baconspoon85/Birdie/README.md

# Birdie
Birdie is 36-key wireless keyboard inspired by Adalyn (Alice/QAZ style)

This as a work in progress. Still need firmware and a case. Feel free to contrtribute if you're interested in moving this along.
