baconspoon85/Birdie/Birdie/Switch Footprint Layout.dxf

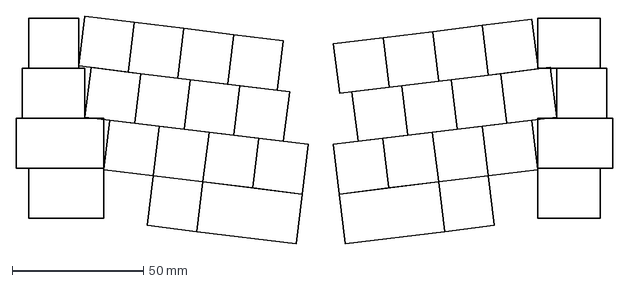
[picture p1: CAD file, 2023-11-30]
Birdie/Switch Footprint Layout.dxf
227.3 x 86.7 mm
