baconspoon85/Birdie/Birdie/Birdie.kicad_pcb

## KiCad design Birdie/Birdie.kicad_pcb (2023-11-30)

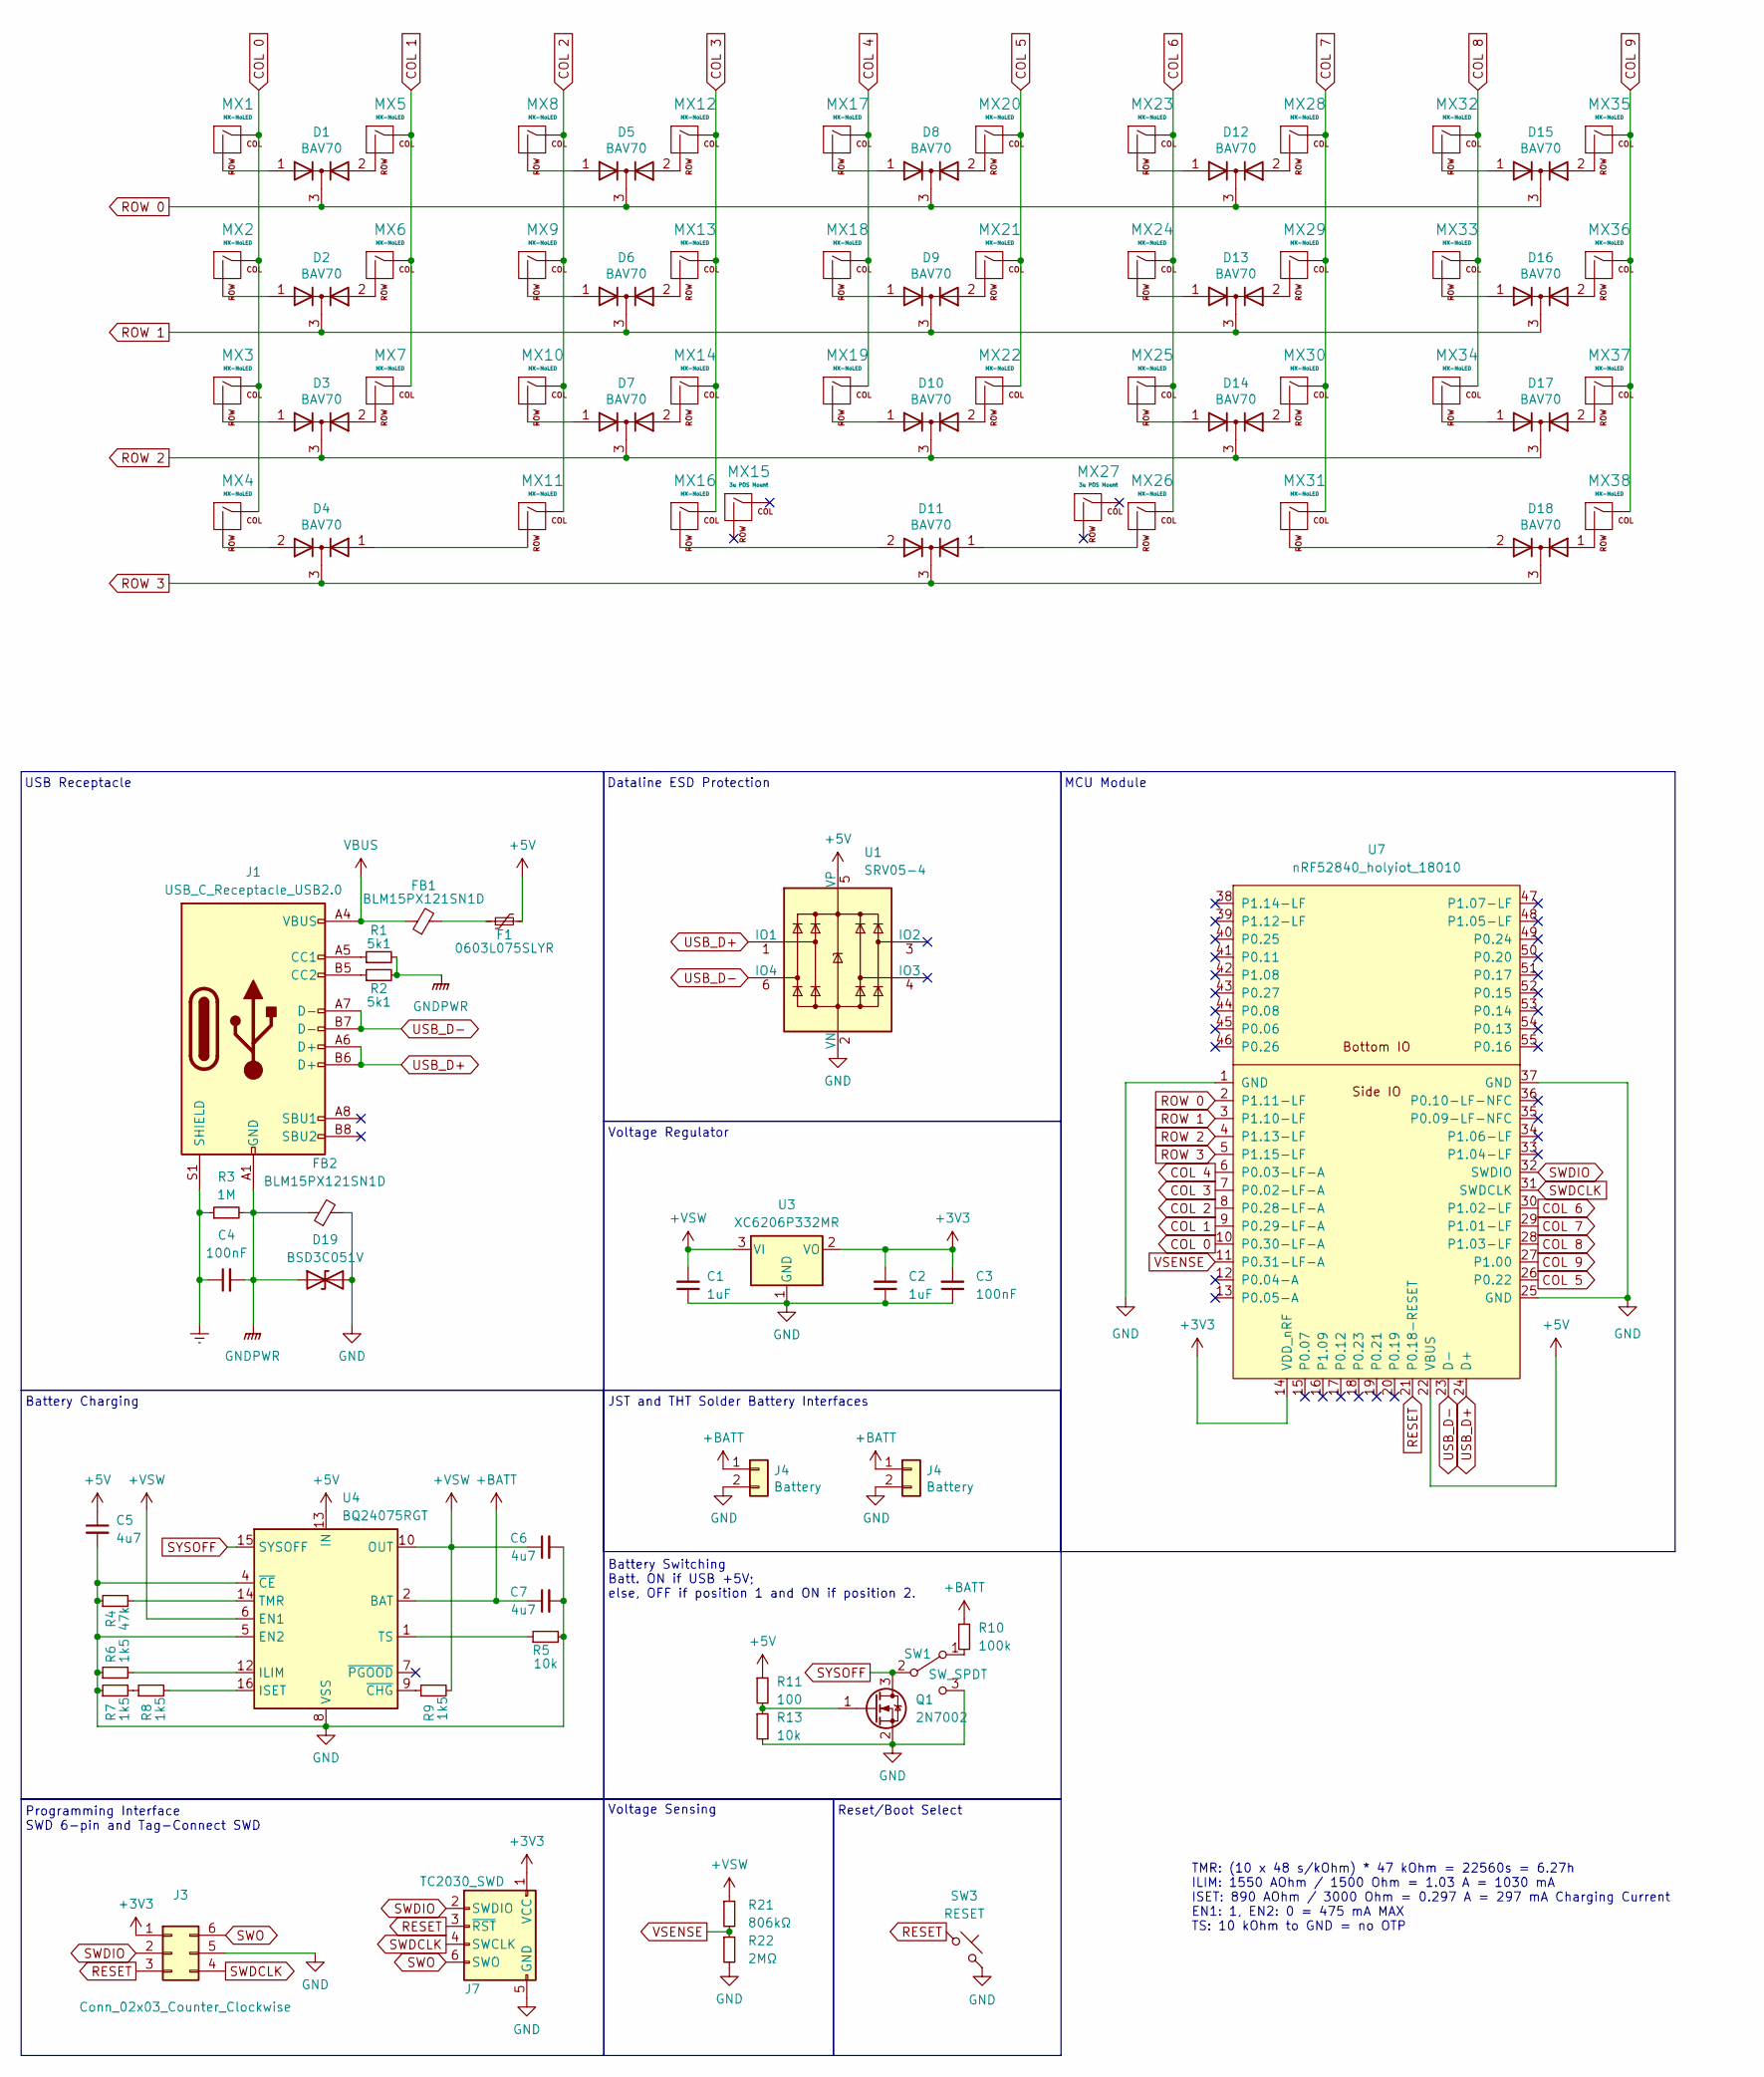
[picture p2: schematic Birdie.kicad_sch]

Parts:
C1, C2: 1uF; C_0402_1005Metric; LCSC C52923
C3, C4: 100nF; C_0402_1005Metric; LCSC C2655418
C5, C6, C7: 4u7; C_0402_1005Metric; LCSC C541466
D1: BAV70; SOT-23; LCSC C154830
D2, D3, D4, D5, D6, D7, D8, D9, D10, D11, D12, D13, D14, D15, D16, D17, D18: BAV70; SOT-23
D19: BSD3C051V; D_SOD-323; LCSC C1519956
F1: 0603L075SLYR; Fuse_0603_1608Metric; LCSC C207016
FB1, FB2: BLM15PX121SN1D; L_0402_1005Metric; LCSC C88970
J1: USB_C_Receptacle_USB2.0; USB_C_Receptacle_HRO_TYPE-C-31-M-12; LCSC C165948
J3: Conn_02x03_Counter_Clockwise; PinHeader_2x03_P2.54mm_Vertical
J4: Battery; JST_PH_S2B-PH-K_1x02_P2.00mm_Horizontal
J7: TC2030_SWD; CON_TC2030_outlined
MX1, MX5, MX6, MX7, MX8, MX9, MX10, MX11, MX12, MX13, MX14, MX17, MX18, MX19, MX20, MX21, MX22, MX23, MX24, MX25, MX28, MX29, MX30, MX31, MX32, MX33, MX34, MX36: MX-NoLED; MXOnly-1U-Hotswap
MX2, MX35, MX38: MX-NoLED; MXOnly-1.25U-Hotswap
MX3: MX-NoLED; MXOnly-1.75U-Hotswap
MX4, MX37: MX-NoLED; MXOnly-1.5U-Hotswap
MX15, MX27: 3u POS Mount; MXOnly-1U-Hotswap
MX16, MX26: MX-NoLED; MXOnly-2U-Hotswap-ReversedStabilizers
Q1: 2N7002; SOT-23; LCSC C8545
R1, R2: 5k1; R_0402_1005Metric; LCSC C103086
R3: 1M; R_0603_1608Metric; LCSC C3016422
R4: 47k; R_0402_1005Metric; LCSC C5455484
R5, R13: 10k; R_0402_1005Metric; LCSC C705657
R6, R7, R8, R9: 1k5; R_0402_1005Metric; LCSC C3015796
R10: 100k; R_0402_1005Metric; LCSC C319963
R11: 100; R_0402_1005Metric; LCSC C319948
R21: 806kΩ; R_0402_1005Metric; LCSC C3016043
R22: 2MΩ; R_0402_1005Metric; LCSC C3015935
SW1: SW_SPDT; SW_SPDT_PCM12; LCSC C221841
SW3: RESET; SW_SPST_TL3342; LCSC C318884
U1: SRV05-4; SOT-23-6-routable; LCSC C2972082
U3: XC6206P332MR; SOT-23-3; LCSC C5250985
U4: BQ24075RGT; VQFN-16-1EP_3x3mm_P0.5mm_EP1.6x1.6mm; LCSC C2865459
U7: nRF52840_holyiot_18010

Connections:
+3V3: C2.2, C3.2, J3.1, U3.2 (VO); also elsewhere on the board
+5V: C5.1, F1.2, R11.1, U1.5 (VP), U4.13 (IN); also elsewhere on the board
+BATT: C7.1, J4.1, R10.1, U4.2 (BAT), U4.3 (BAT); also elsewhere on the board
+VSW: C1.2, C6.1, R9.2, U3.3 (VI), U4.6 (EN1), U4.10 (OUT), U4.11 (OUT); also elsewhere on the board
COL 0: MX1.1 (COL), MX2.1 (COL), MX3.1 (COL), MX4.1 (COL); also elsewhere on the board
COL 1: MX5.1 (COL), MX6.1 (COL), MX7.1 (COL); also elsewhere on the board
COL 2: MX8.1 (COL), MX9.1 (COL), MX10.1 (COL), MX11.1 (COL); also elsewhere on the board
COL 3: MX12.1 (COL), MX13.1 (COL), MX14.1 (COL), MX16.1 (COL); also elsewhere on the board
COL 4: MX17.1 (COL), MX18.1 (COL), MX19.1 (COL); also elsewhere on the board
COL 5: MX20.1 (COL), MX21.1 (COL), MX22.1 (COL); also elsewhere on the board
COL 6: MX23.1 (COL), MX24.1 (COL), MX25.1 (COL), MX26.1 (COL); also elsewhere on the board
COL 7: MX28.1 (COL), MX29.1 (COL), MX30.1 (COL), MX31.1 (COL); also elsewhere on the board
COL 8: MX32.1 (COL), MX33.1 (COL), MX34.1 (COL); also elsewhere on the board
COL 9: MX35.1 (COL), MX36.1 (COL), MX37.1 (COL), MX38.1 (COL); also elsewhere on the board
Earth: C4.1, J1.S1 (SHIELD), R3.1
GND: C1.1, C2.1, C3.1, C5.2, C6.2, C7.2, D19.2 (A2), FB2.2, J3.5, J4.2, Q1.2 (S), R4.1, R5.2, R6.1, R7.1, R13.2, SW1.3 (C), U1.2 (VN), U3.1 (GND), U4.4 (~CE), U4.5 (EN2), U4.8 (VSS), U4.17 (VSS); also elsewhere on the board
GNDPWR: C4.2, D19.1 (A1), FB2.1, J1.A1 (GND), J1.A12 (GND), J1.B1 (GND), J1.B12 (GND), R1.2, R2.2, R3.2
unnamed: F1.1, FB1.2
unnamed: J1.A5 (CC1), R1.1
unnamed: J1.B5 (CC2), R2.1
unnamed: D1.1 (A), MX1.2 (ROW)
unnamed: D2.1 (A), MX2.2 (ROW)
unnamed: D3.1 (A), MX3.2 (ROW)
unnamed: D4.2 (A), MX4.2 (ROW)
unnamed: D1.2 (A), MX5.2 (ROW)
unnamed: D2.2 (A), MX6.2 (ROW)
unnamed: D3.2 (A), MX7.2 (ROW)
unnamed: D5.1 (A), MX8.2 (ROW)
unnamed: D6.1 (A), MX9.2 (ROW)
unnamed: D7.1 (A), MX10.2 (ROW)
unnamed: D4.1 (A), MX11.2 (ROW)
unnamed: D5.2 (A), MX12.2 (ROW)
unnamed: D6.2 (A), MX13.2 (ROW)
unnamed: D7.2 (A), MX14.2 (ROW)
unnamed: D11.2 (A), MX16.2 (ROW)
unnamed: D8.1 (A), MX17.2 (ROW)
unnamed: D9.1 (A), MX18.2 (ROW)
unnamed: D10.1 (A), MX19.2 (ROW)
unnamed: D8.2 (A), MX20.2 (ROW)
unnamed: D9.2 (A), MX21.2 (ROW)
unnamed: D10.2 (A), MX22.2 (ROW)
unnamed: D12.1 (A), MX23.2 (ROW)
unnamed: D13.1 (A), MX24.2 (ROW)
unnamed: D14.1 (A), MX25.2 (ROW)
unnamed: D11.1 (A), MX26.2 (ROW)
unnamed: D12.2 (A), MX28.2 (ROW)
unnamed: D13.2 (A), MX29.2 (ROW)
unnamed: D14.2 (A), MX30.2 (ROW)
unnamed: D18.2 (A), MX31.2 (ROW)
unnamed: D15.1 (A), MX32.2 (ROW)
unnamed: D16.1 (A), MX33.2 (ROW)
unnamed: D17.1 (A), MX34.2 (ROW)
unnamed: D15.2 (A), MX35.2 (ROW)
unnamed: D16.2 (A), MX36.2 (ROW)
unnamed: D17.2 (A), MX37.2 (ROW)
unnamed: D18.1 (A), MX38.2 (ROW)
unnamed: Q1.1 (G), R11.2, R13.1
unnamed: R7.2, R8.1
unnamed: R10.2, SW1.1 (A)
unnamed: R6.2, U4.12 (ILIM)
unnamed: R8.2, U4.16 (ISET)
unnamed: R4.2, U4.14 (TMR)
unnamed: R5.1, U4.1 (TS)
unnamed: R9.1, U4.9 (~CHG)
RESET: J3.3; also elsewhere on the board
ROW 0: D1.3 (K), D5.3 (K), D8.3 (K), D12.3 (K), D15.3 (K); also elsewhere on the board
ROW 1: D2.3 (K), D6.3 (K), D9.3 (K), D13.3 (K), D16.3 (K); also elsewhere on the board
ROW 2: D3.3 (K), D7.3 (K), D10.3 (K), D14.3 (K), D17.3 (K); also elsewhere on the board
ROW 3: D4.3 (K), D11.3 (K), D18.3 (K); also elsewhere on the board
SWDCLK: J3.4; also elsewhere on the board
SWDIO: J3.2; also elsewhere on the board
SWO: J3.6; also elsewhere on the board
SYSOFF: Q1.3 (D), SW1.2 (B), U4.15 (SYSOFF)
USB_D+: J1.A6 (D+), J1.B6 (D+), U1.1 (IO1); also elsewhere on the board
USB_D-: J1.A7 (D-), J1.B7 (D-), U1.6 (IO4); also elsewhere on the board
VBUS: FB1.1, J1.A4 (VBUS), J1.A9 (VBUS), J1.B4 (VBUS), J1.B9 (VBUS)

Notes on the sheet:
MCU Module
Reset/Boot Select
Programming Interface SWD 6-pin and Tag-Connect SWD
JST and THT Solder Battery Interfaces
Dataline ESD Protection
TMR: (10 x 48 s/kOhm) * 47 kOhm = 22560s = 6.27h ILIM: 1550 AOhm / 1500 Ohm = 1.03 A = 1030 mA ISET: 890 AOhm / 3000 Ohm = 0.297 A = 297 mA Charging Current EN1: 1, EN2: 0 = 475 mA MAX TS: 10 kOhm to GND = no OTP
USB Receptacle
Voltage Sensing
Battery Charging
Battery Switching Batt. ON if USB +5V; else, OFF if position 1 and ON if position 2.
Voltage Regulator

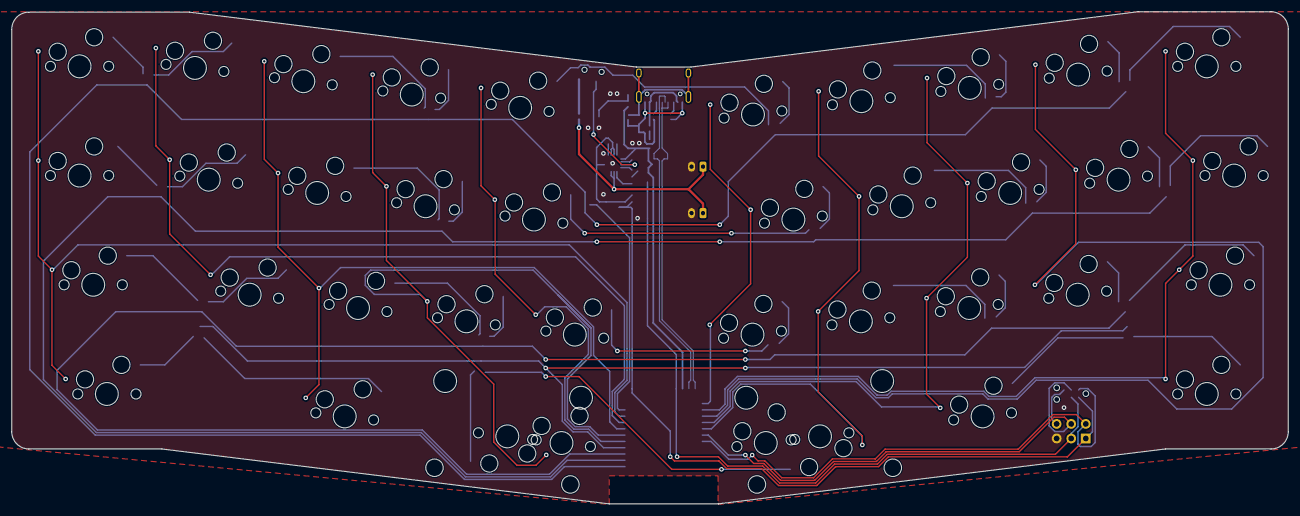
[picture p3: board Birdie.kicad_pcb from above]

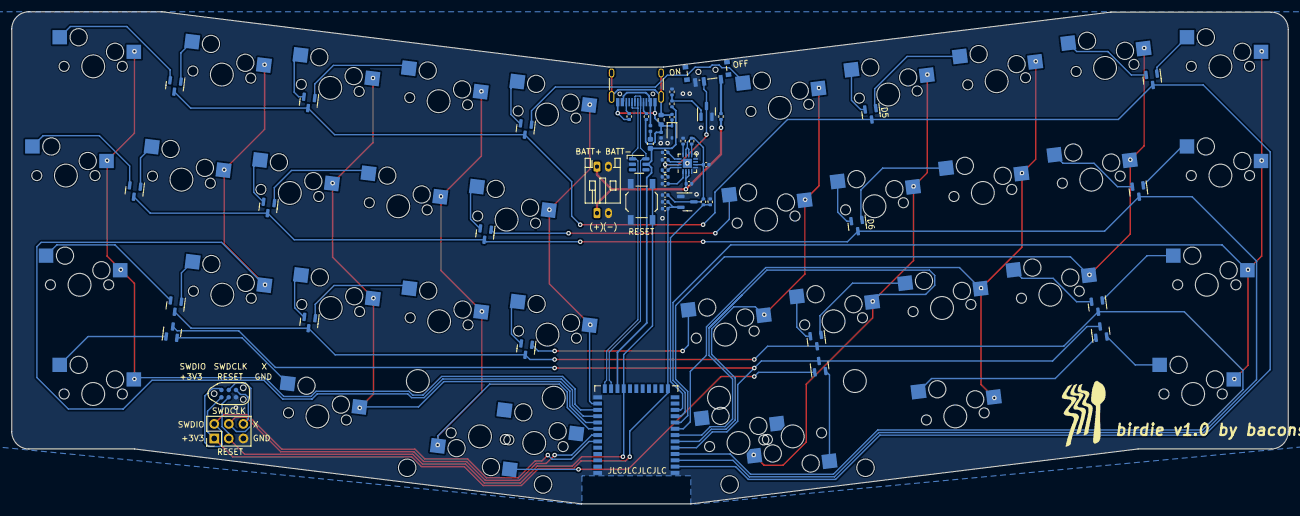
[picture p4: board Birdie.kicad_pcb from below]

Board: 2 copper layers, 222.7 x 85.8 mm, 94 parts (56 on the bottom side), 77 nets.

Other parts of the board:
G1: LOGO; baconspoon-logo-13x14mm
J2: TC2030_SWD; CON_TC2030_outlined
J5: Battery; JST_PH_S2B-PH-K_1x02_P2.00mm_Horizontal
R12: 806kΩ; R_0402_1005Metric
R14: 2MΩ; R_0402_1005Metric
SW2: RESET; SW_SPST_TL3342
U2: nRF52840_holyiot_18010

Their connections:
+3V3: J2.1 (VCC), U2.14 (VDD_nRF); also elsewhere on the board
+5V: U2.22 (VBUS); also elsewhere on the board
+BATT: J5.1; also elsewhere on the board
+VSW: R12.1; also elsewhere on the board
COL 0: U2.10 (P0.30-LF-A); also elsewhere on the board
COL 1: U2.9 (P0.29-LF-A); also elsewhere on the board
COL 2: U2.8 (P0.28-LF-A); also elsewhere on the board
COL 3: U2.7 (P0.02-LF-A); also elsewhere on the board
COL 4: U2.6 (P0.03-LF-A); also elsewhere on the board
COL 5: U2.26 (P0.22); also elsewhere on the board
COL 6: U2.30 (P1.02-LF); also elsewhere on the board
COL 7: U2.29 (P1.01-LF); also elsewhere on the board
COL 8: U2.28 (P1.03-LF); also elsewhere on the board
COL 9: U2.27 (P1.00); also elsewhere on the board
GND: J2.5 (GND), J5.2, R14.2, SW2.2, U2.1 (GND), U2.25 (GND), U2.37 (GND); also elsewhere on the board
RESET: J2.3 (~RST), SW2.1, U2.21 (P0.18-RESET); also elsewhere on the board
ROW 0: U2.2 (P1.11-LF); also elsewhere on the board
ROW 1: U2.3 (P1.10-LF); also elsewhere on the board
ROW 2: U2.4 (P1.13-LF); also elsewhere on the board
ROW 3: U2.5 (P1.15-LF); also elsewhere on the board
SWDCLK: J2.4 (SWCLK), U2.31 (SWDCLK); also elsewhere on the board
SWDIO: J2.2 (SWDIO), U2.32 (SWDIO); also elsewhere on the board
SWO: J2.6 (SWO); also elsewhere on the board
USB_D+: U2.24 (D+); also elsewhere on the board
USB_D-: U2.23 (D-); also elsewhere on the board
VSENSE: R12.2, R14.1, U2.11 (P0.31-LF-A)
